agooddaytowork/dq-speaker/media/dsp-app-mixed-channel.jpg

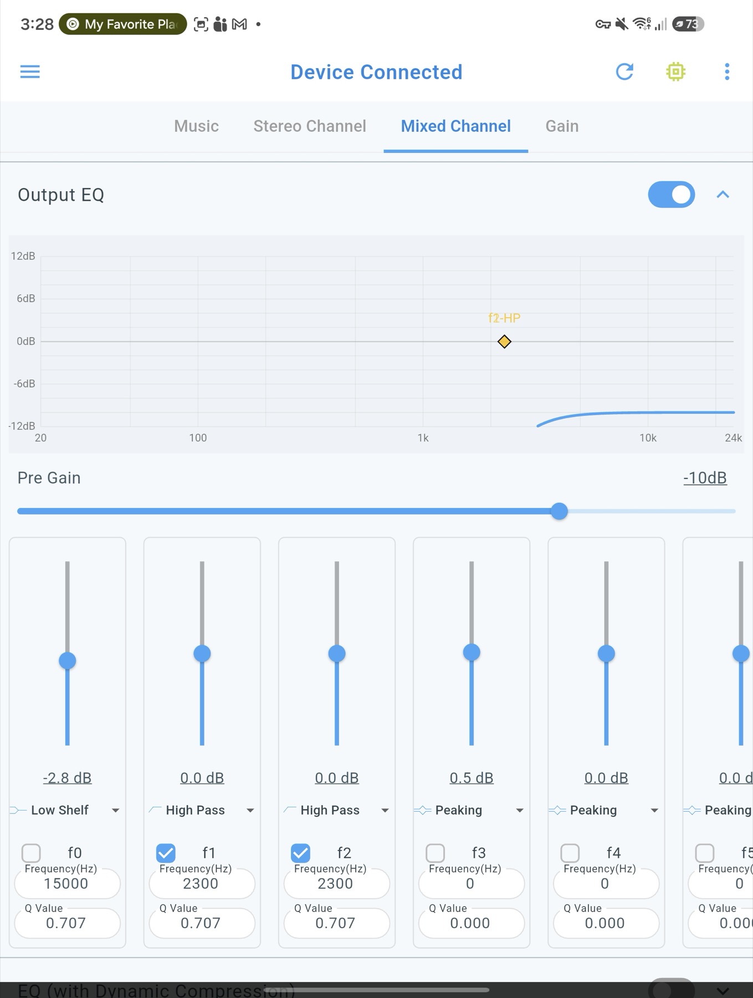
media/dsp-app-mixed-channel.jpg
