agooddaytowork/dq-speaker/media/dsp-app-stereo-crossover.jpg

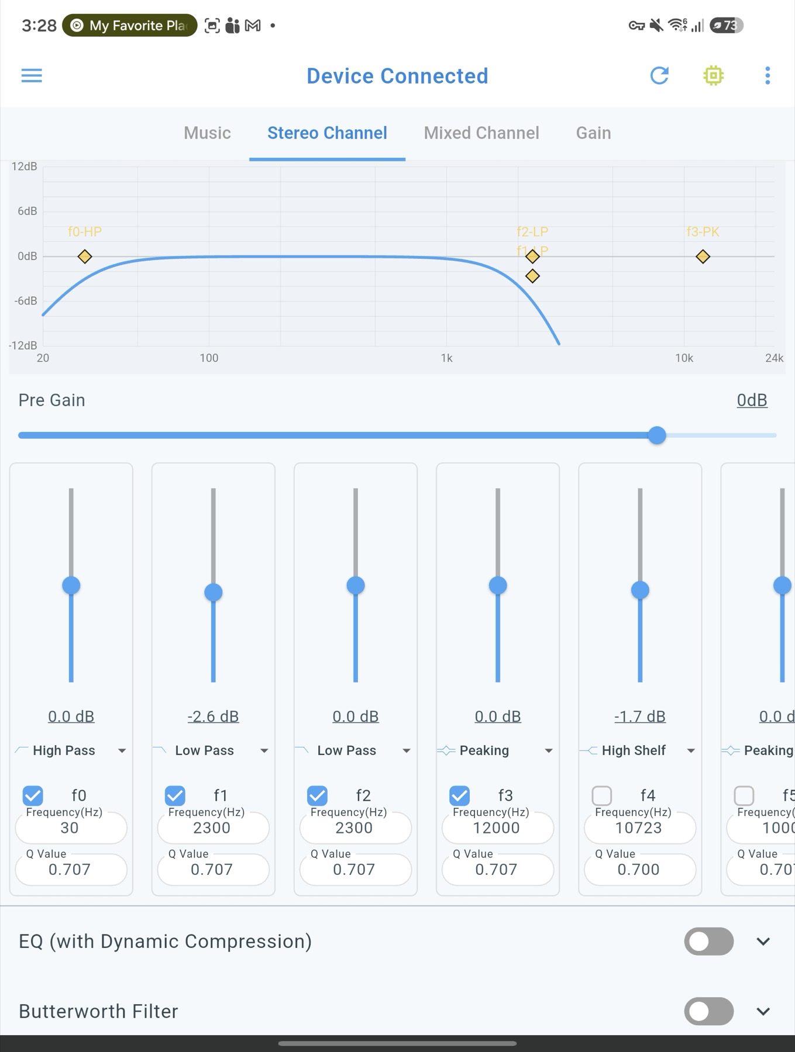
media/dsp-app-stereo-crossover.jpg
