agooddaytowork/dq-speaker/media/dsp-app-virtual-bass.jpg

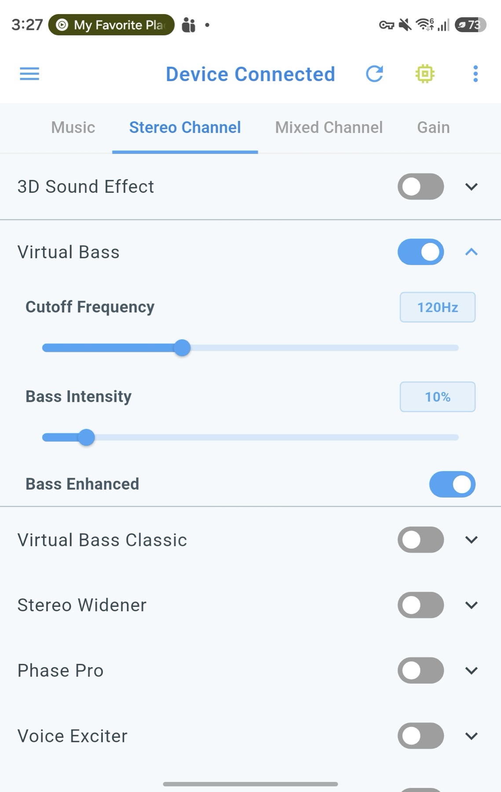
media/dsp-app-virtual-bass.jpg
