agooddaytowork/dq-speaker/media/frequency-response.jpg

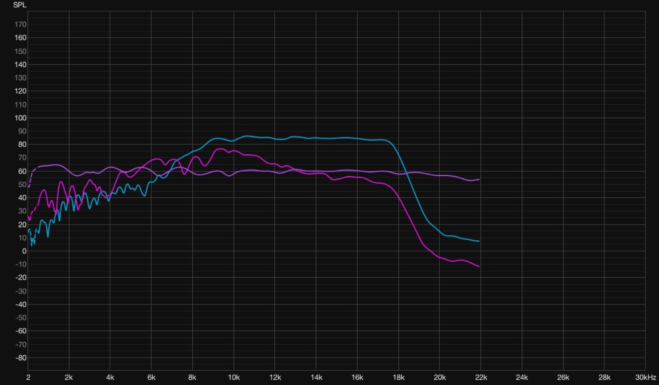
media/frequency-response.jpg
