agooddaytowork/dq-speaker/media/prototype-bench.jpg

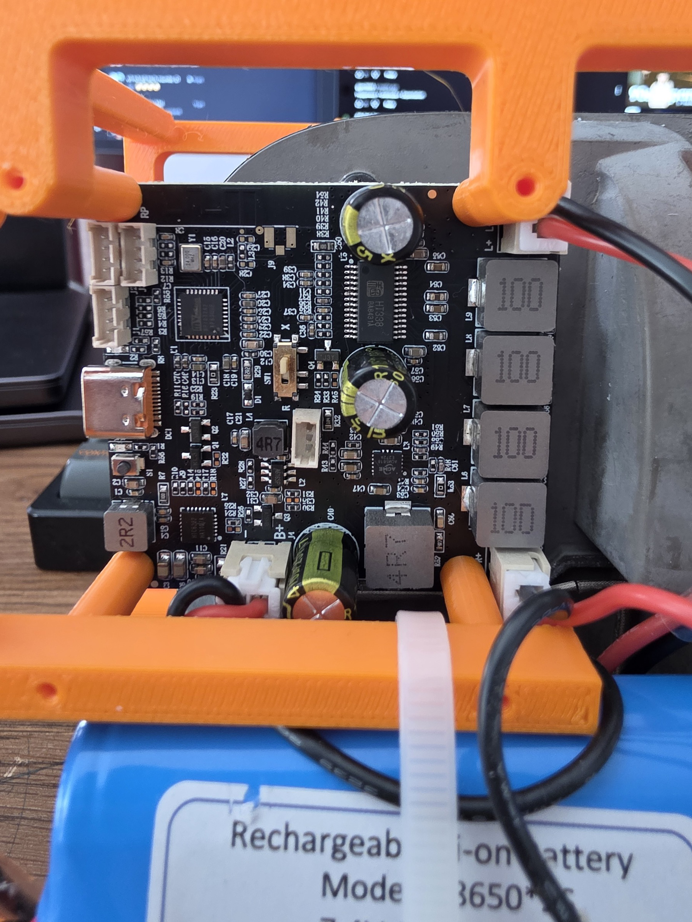
media/prototype-bench.jpg
