agooddaytowork/dq-speaker/media/rew-workbench.jpg

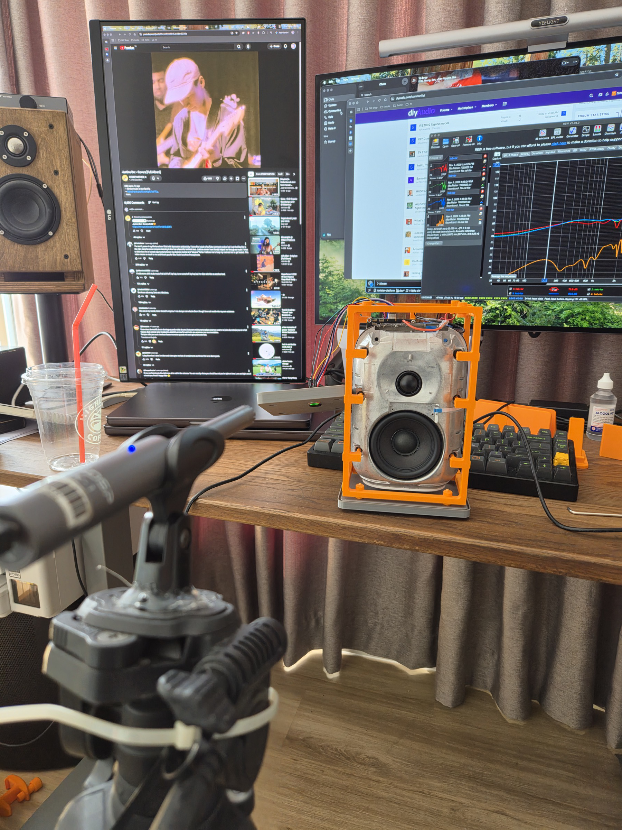
media/rew-workbench.jpg
