agooddaytowork/dq-speaker/cad/step/SONOS_CASE_RECTANGULAR_V1.step

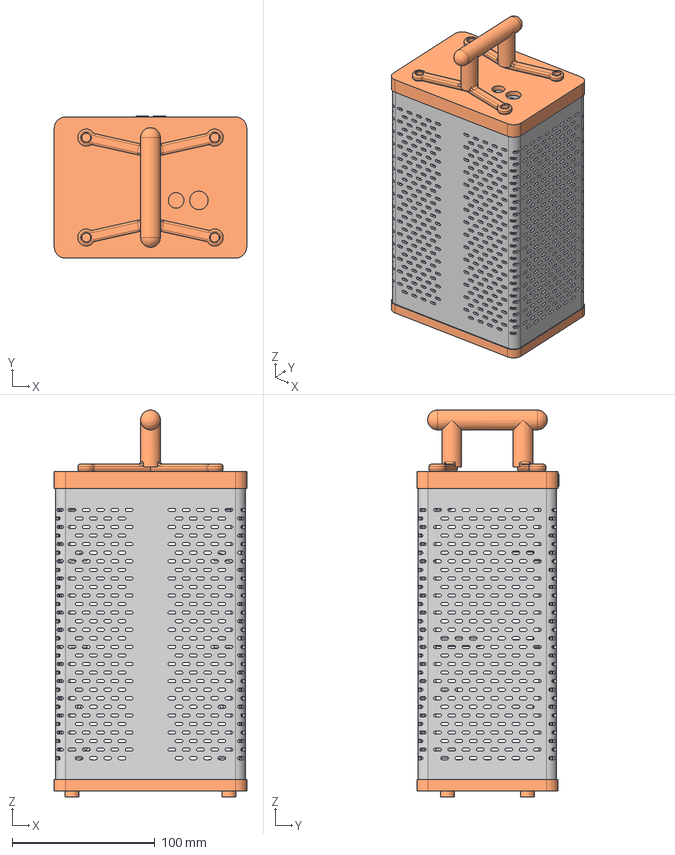
[picture p8: CAD file, 2026-11-06]
cad/step/SONOS_CASE_RECTANGULAR_V1.step
135.0 x 99.8 x 271.2 mm
