agooddaytowork/dq-speaker/stl/06-v-handle.stl

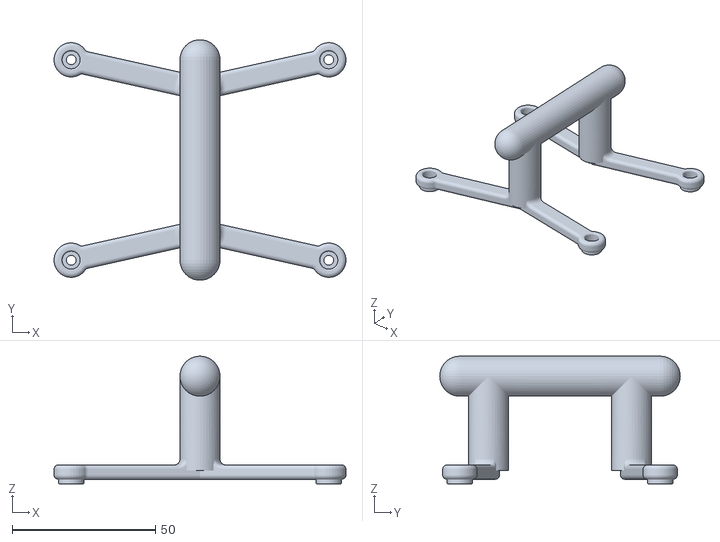
[picture p9: CAD file, 2026-11-06]
stl/06-v-handle.stl
102.0 x 84.0 x 44.6
