agooddaytowork/dq-speaker/stl/03-outer-sleeve.stl

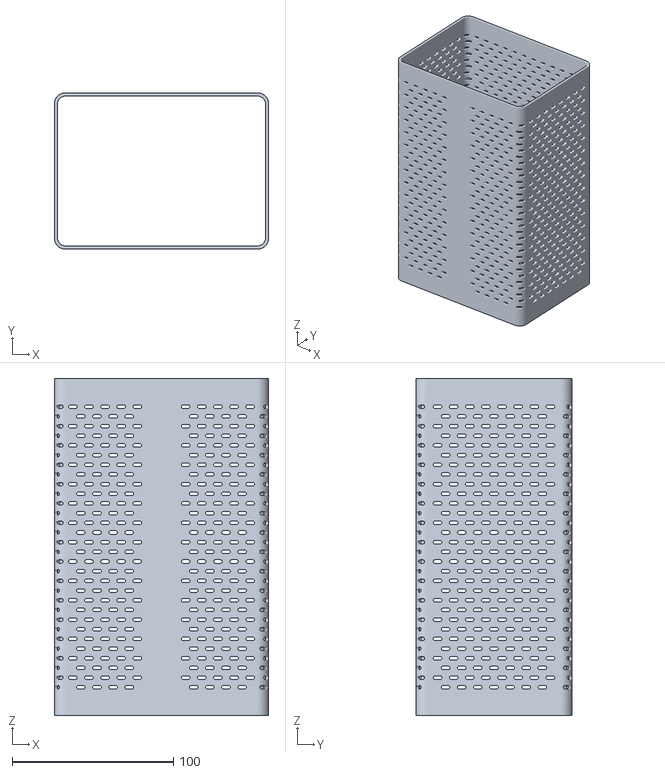
[picture p10: CAD file, 2026-11-06]
stl/03-outer-sleeve.stl
133.0 x 97.0 x 209.0
