agooddaytowork/dq-speaker/stl/05-bottom-cap.stl

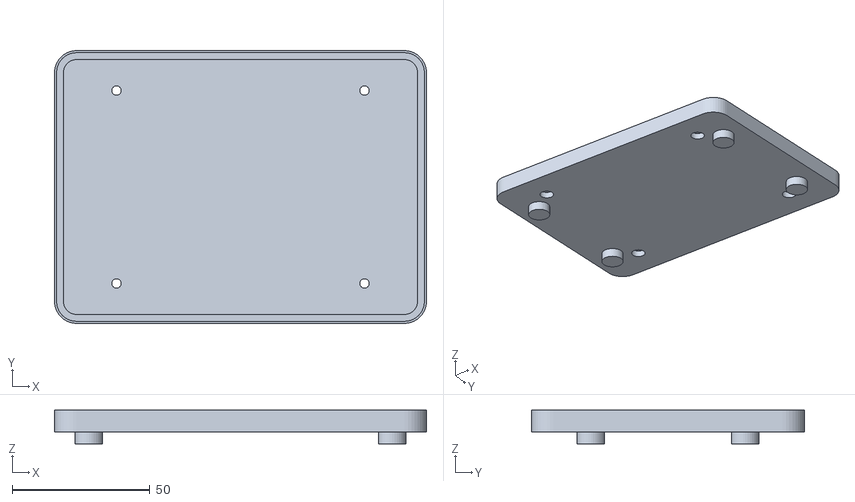
[picture p11: CAD file, 2026-11-06]
stl/05-bottom-cap.stl
135.0 x 99.0 x 12.2
