agooddaytowork/dq-speaker/stl/01-rear-frame.stl

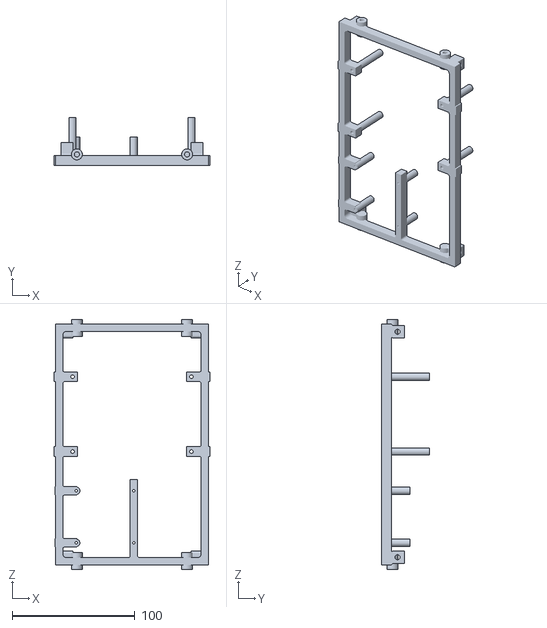
[picture p12: CAD file, 2026-11-06]
stl/01-rear-frame.stl
127.0 x 39.0 x 204.0
