agooddaytowork/dq-speaker/stl/02-front-frame.stl

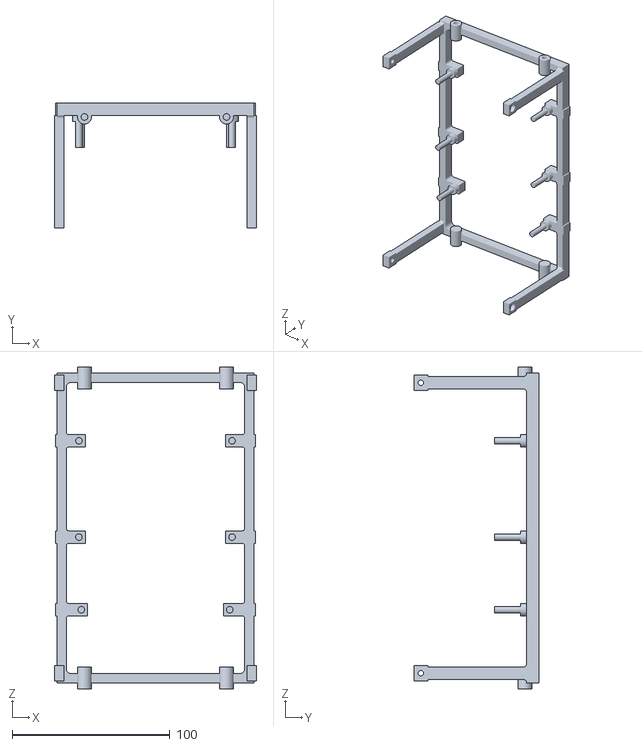
[picture p13: CAD file, 2026-11-06]
stl/02-front-frame.stl
128.0 x 79.5 x 204.0
