agooddaytowork/dq-speaker/stl/04-top-cap.stl

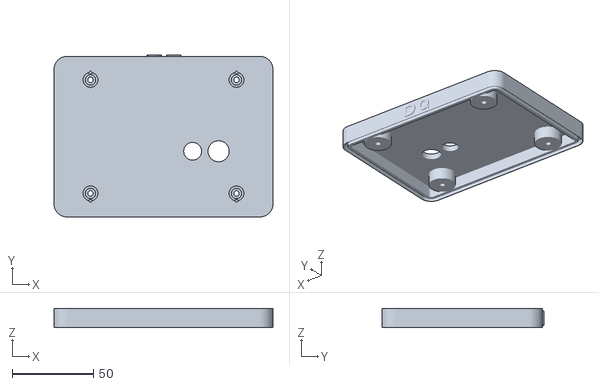
[picture p14: CAD file, 2026-11-06]
stl/04-top-cap.stl
135.0 x 99.8 x 12.0
