agooddaytowork/dq-speaker/stl/10-top-screw-plug-04.stl

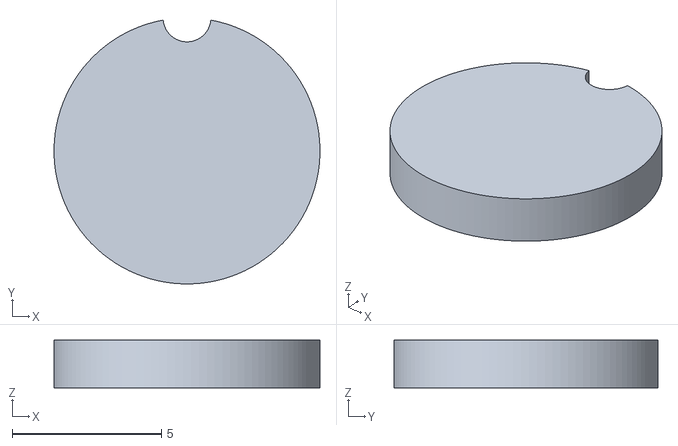
[picture p15: CAD file, 2026-11-06]
stl/10-top-screw-plug-04.stl
8.90 x 8.83 x 1.60
