agooddaytowork/dq-speaker/(list of files, cad)

Other CAD files:
stl/07-top-screw-plug-01.stl
stl/08-top-screw-plug-02.stl
stl/09-top-screw-plug-03.stl
