agooddaytowork/dq-speaker/media/frame-fit-test.jpg

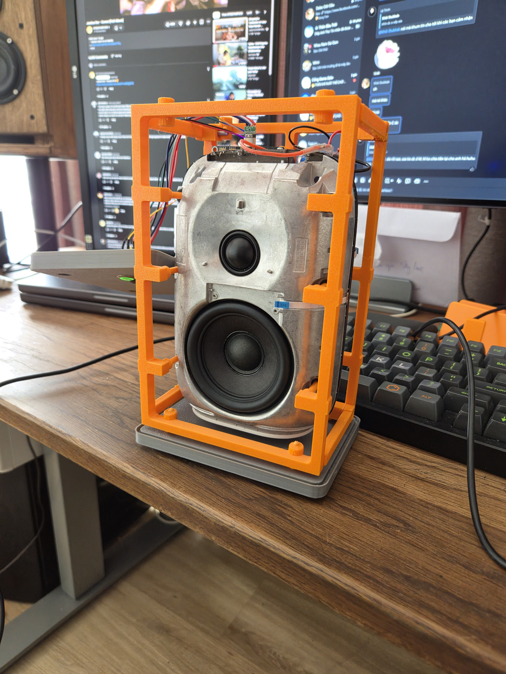
media/frame-fit-test.jpg
