agooddaytowork/dq-speaker/(commit log)

2026-11-06 Open-source DQ Speaker mechanical design
    [01-rear-frame.stl, 02-front-frame.stl, 03-outer-sleeve.stl, 04-top-cap.stl, 05-bottom-cap.stl, 06-v-handle.stl, 07-top-screw-plug-01.stl, 08-top-screw-plug-02.stl]
2026-11-06 Identify Nest Audio donor speakers and clarify crossover measurements
    [BOM.csv]
